mabecabu/farasis_p10a_pack/pcb/bms/bms.xlsx

Prj: | bms.xml |  |  |  |  | Board Qty: | 100
Co.: |  |  |  |  |  | Unit Cost: | $0.00
Prj date: | 5/12/2021 21:36:38 |  |  |  |  | Total Cost: | $0.00 |  |  |  | $0.00 | 0 |  |  |  | $0.00 | 0
$ date: | 2021-05-12 21:39:04
Global Part Info |  |  |  |  |  |  |  | Digi-Key |  |  |  |  | Mouser
Refs | Value | Footprint | Manf | Manf# | Qty | Unit$ | Ext$ | Avail | Purch | Unit$ | Ext$ | Cat# | Avail | Purch | Unit$ | Ext$ | Cat#
C1,C12 | 100p | C_0805_2012Metric | Kemet | C0805C101J1GACTU | 0 | $0.00 | $0.00 | 155151 |  | $0.00 | $0.00 | 399-1123-1-ND (https://octopart.com/click/track?ai=8078&sig=00b587c&sid=459&ppid=123666&vpid=1531783&ct=offers) | 46286 |  | $0.00 | $0.00 | 80C0805C101J1G (https://octopart.com/click/track?ai=8078&sig=068e5c8&sid=2401&ppid=123666&vpid=37714615&ct=offers)
C11,C21,C28,C29 | 1u | C_0805_2012Metric | Samsung Electro-Mechanics | CL21B105KBFNNNG | 0 | $0.00 | $0.00 | 1395000 |  | $0.00 | $0.00 | 1276-6470-1-ND (https://octopart.com/click/track?ai=8078&sig=0e430a3&sid=459&ppid=19995687&vpid=254014556&ct=offers) | NonStk |  | $0.00 | $0.00 | 187CL21B105KBFNNNG (https://octopart.com/click/track?c=1&ai=8078&sig=0276fd4&sid=2401&ppid=19995687&vpid=659501615&ct=offers)
C13 | 470n | C_0805_2012Metric | Samsung Electro-Mechanics | CL21B473KCCWPNC | 0 | $0.00 | $0.00 | 187459 |  | $0.00 | $0.00 | 1276-6815-1-ND (https://octopart.com/click/track?ai=8078&sig=045a58f&sid=459&ppid=30507372&vpid=254260088&ct=offers) | 79715 |  | $0.00 | $0.00 | 187CL21B473KCCWPNC (https://octopart.com/click/track?ai=8078&sig=072d3b9&sid=2401&ppid=30507372&vpid=659501796&ct=offers)
C15 | 4.7u | C_0805_2012Metric | Samsung Electro-Mechanics | CL21A475KOCLRNC | 0 | $0.00 | $0.00 | 180000 |  | $0.00 | $0.00 | 1276-2416-1-ND (https://octopart.com/click/track?ai=8078&sig=04f091f&sid=459&ppid=19832222&vpid=72525891&ct=offers) | 63245 |  | $0.00 | $0.00 | 187CL21A475KOCLRNC (https://octopart.com/click/track?ai=8078&sig=0216e42&sid=2401&ppid=19832222&vpid=658751409&ct=offers)
C2,C16-C20,C23,C27,C30-C33 | 100n | C_0805_2012Metric | Samsung Electro-Mechanics | CL21B104KCFSFNE | 0 | $0.00 | $0.00 | 466 |  | $0.00 | $0.00 | 1276-2923-1-ND (https://octopart.com/click/track?ai=8078&sig=090676c&sid=459&ppid=19832274&vpid=72526089&ct=offers) | 8757 |  | $0.00 | $0.00 | 187CL21B104KCFSFNE (https://octopart.com/click/track?ai=8078&sig=059a113&sid=2401&ppid=19832274&vpid=659501593&ct=offers)
C22 | 10n | C_0805_2012Metric | Samsung Electro-Mechanics | CL21B103KBANNNC | 0 | $0.00 | $0.00 | 821659 |  | $0.00 | $0.00 | 1276-1015-1-ND (https://octopart.com/click/track?ai=8078&sig=068d027&sid=459&ppid=9299349&vpid=72526018&ct=offers) | 15878 |  | $0.00 | $0.00 | 187CL21B103KBANNNC (https://octopart.com/click/track?ai=8078&sig=0e57c83&sid=2401&ppid=9299349&vpid=659501561&ct=offers)
C26 | 22n | C_0805_2012Metric | Samsung Electro-Mechanics | CL21B223KBANFNC | 0 | $0.00 | $0.00 | 74889 |  | $0.00 | $0.00 | 1276-2488-1-ND (https://octopart.com/click/track?ai=8078&sig=08f2074&sid=459&ppid=19832343&vpid=72526332&ct=offers) | 158177 |  | $0.00 | $0.00 | 187CL21B223KBANFNC (https://octopart.com/click/track?ai=8078&sig=0c7c7af&sid=2401&ppid=19832343&vpid=659501677&ct=offers)
C34,C36 | 8p | C_0805_2012Metric | Yaego | CC0805CRNPO9BN8R0 | 0 | $0.00 | $0.00 | 7888 |  | $0.00 | $0.00 | 311-4151-1-ND (https://octopart.com/click/track?c=1&ai=8078&sig=04d3e2d&sid=459&ppid=71334518&vpid=457175430&ct=offers)
C35 | 2.2u | C_0805_2012Metric | Samsung Electro-Mechanics | CL21B225KPFNNNE | 0 | $0.00 | $0.00 | 230183 |  | $0.00 | $0.00 | 1276-1188-1-ND (https://octopart.com/click/track?ai=8078&sig=0da4d98&sid=459&ppid=9291904&vpid=72526426&ct=offers) | 39439 |  | $0.00 | $0.00 | 187CL21B225KPFNNNE (https://octopart.com/click/track?ai=8078&sig=042a960&sid=2401&ppid=9291904&vpid=658751446&ct=offers)
C3-C10,C14,C24,C25 | 220n | C_0805_2012Metric | Kemet | C0805C224K1RECAUTO | 0 | $0.00 | $0.00 | 7989 |  | $0.00 | $0.00 | 399-17890-1-ND (https://octopart.com/click/track?ai=8078&sig=00debeb&sid=459&ppid=91527630&vpid=477966265&ct=offers) | 12561 |  | $0.00 | $0.00 | 80C0805C224K1RECAUT (https://octopart.com/click/track?ai=8078&sig=0cb96bb&sid=2401&ppid=91527630&vpid=481662233&ct=offers)
D1,D3,D5 | 100V | D_SOD-123 | Diodes Inc | BAT46W-7-F | 0 | $0.00 | $0.00
D2,D4 | 16V | D_SOD-123 | Diodes Inc | MMSZ5246B-7-F | 0 | $0.00 | $0.00
D9 | 48V | D_SMB | Littelfuse | SMBJ48A | 0 | $0.00 | $0.00 | 4662 |  | $0.00 | $0.00 | SMBJ48ALFCT-ND (https://octopart.com/click/track?ai=8078&sig=0f7ec1f&sid=459&ppid=350932&vpid=1629154&ct=offers) | 2092 |  | $0.00 | $0.00 | 576SMBJ48A (https://octopart.com/click/track?ai=8078&sig=00584be&sid=2401&ppid=350932&vpid=37738827&ct=offers)
D6-D8 | 5.5V | SOT-23 | TI | TPD2E2U06QDBZRQ1 | 0 | $0.00 | $0.00 | NonStk |  | $0.00 | $0.00 | 296-40695-1-ND (https://octopart.com/click/track?c=1&ai=8078&sig=0e8c40f&sid=459&ppid=52437806&vpid=192871289&ct=offers) | 3175 |  | $0.00 | $0.00 | 595TPD2E2U06QDBZRQ1 (https://octopart.com/click/track?ai=8078&sig=066c468&sid=2401&ppid=52437806&vpid=201388535&ct=offers)
H5-H8 | MountingHole | MountingHole_3.2mm_M3 |  |  | 0 | $0.00 | $0.00
J1 | Taps 0-5 | PinHeader_1x05_P2.54mm_Vertical |  |  | 0 | $0.00 | $0.00
J10 | Signals | Hirose_DF62WZ-9P-2.2DSA | Hirose Electric Co Ltd | DF62WZ-9P-2.2DSA(50) | 0 | $0.00 | $0.00
J2 | Taps 6-8 | PinHeader_1x04_P2.54mm_Vertical |  |  | 0 | $0.00 | $0.00
J3 | Taps 9-10 | PinHeader_1x02_P2.54mm_Vertical |  |  | 0 | $0.00 | $0.00
J4 | Batt- Out | 74651195R | Wurth Elektronik | 74651195R | 0 | $0.00 | $0.00
J5 | Batt+ In | 74651195R | Wurth Elektronik | 74651195R | 0 | $0.00 | $0.00
J6 | Batt- In | 74651195R | Wurth Elektronik | 74651195R | 0 | $0.00 | $0.00
J7 | Batt+ Out | 74651195R | Wurth Elektronik | 74651195R | 0 | $0.00 | $0.00
J8 | SWD | PinHeader_1x04_P2.54mm_Horizontal | Adam Tech | PH1RB-04-UA | 0 | $0.00 | $0.00
J9 | Thermistors | JST_NSH_SM04B-NSHSS-TB_1x04-1MP_P1.00mm_Vertical | JST | SM04B-NSHSS-TB (LF)(SN) | 0 | $0.00 | $0.00 | 3449 |  | $0.00 | $0.00 | 455-2774-1-ND (https://octopart.com/click/track?ai=8078&sig=0c04254&sid=459&ppid=22884277&vpid=50103598&ct=offers)
JP7,JP9 | Jumper_NO_Small | SolderJumper-2_P1.3mm_Open_RoundedPad1.0x1.5mm |  |  | 0 | $0.00 | $0.00
Q1 | FCX495TA | SOT-89-3 | Diodes Inc | FCX495TA | 0 | $0.00 | $0.00
Q2,Q3 | CSD19506KTT | TO-263-2 | TI | CSD19506KTT | 0 | $0.00 | $0.00 | 129 |  | $0.00 | $0.00 | 296-49604-1-ND (https://octopart.com/click/track?ai=8078&sig=0270565&sid=459&ppid=71513265&vpid=486679130&ct=offers) | 438 |  | $0.00 | $0.00 | 595CSD19506KTT (https://octopart.com/click/track?ai=8078&sig=0b78196&sid=2401&ppid=71513265&vpid=261392702&ct=offers)
Q4,Q5 | ZXMP10A13FTA | SOT-23 | Diodes Inc | ZXMP10A13FTA | 0 | $0.00 | $0.00
R1,R3,R36 | 100 | R_0805_2012Metric | Bourns Inc | CR0805-FX-1000ELF | 0 | $0.00 | $0.00
R2 | 1m | R_2512_6332Metric | Riedon | CSR2512C0R001F | 0 | $0.00 | $0.00 | 30118 |  | $0.00 | $0.00 | 696-1185-1-ND (https://octopart.com/click/track?c=1&ai=8078&sig=0b731cc&sid=459&ppid=29379677&vpid=77874757&ct=offers)
R20,R21 | 150 | R_0805_2012Metric | Stackpole Electronics | RMCF0805FT150R | 0 | $0.00 | $0.00
R25,R31,R33 | 5.1k | R_0805_2012Metric | Stackpole Electronics | RMCF0805FT5K10 | 0 | $0.00 | $0.00
R28 | 1k | R_0805_2012Metric | Bourns Inc | CR0805-FX-1001ELF | 0 | $0.00 | $0.00
R29,R35 | 3.9k | R_0805_2012Metric | Stackpole Electronics | RMCF0805FT3K90 | 0 | $0.00 | $0.00
R30,R34 | 1M | R_0805_2012Metric | Stackpole Electronics | RMCF0805FT1M00 | 0 | $0.00 | $0.00
R32 | 10M | R_0805_2012Metric | Stackpole Electronics | RMCF0805FT10M0 | 0 | $0.00 | $0.00
R42 | Rext | R_0805_2012Metric |  |  | 0 | $0.00 | $0.00
R15-R19,R22-R24,R26,R27,R39 | 10k | R_0805_2012Metric | Stackpole Electronics | RMCF0805FT10K0 | 0 | $0.00 | $0.00
R4-R14,R37,R38,R40,R41 | 20 | R_0805_2012Metric | Stackpole Electronics | RMCF0805FT20R0 | 0 | $0.00 | $0.00
SW1 | Boot | SW_SPST_PTS645 | C&K | PTS645SK50SMTR92 LFS | 0 | $0.00 | $0.00 | 86667 |  | $0.00 | $0.00 | CKN9087CT-ND (https://octopart.com/click/track?ai=8078&sig=09e5738&sid=459&ppid=55397152&vpid=76879281&ct=offers) | 16210 |  | $0.00 | $0.00 | 611PTS645SK50SMTR92 (https://octopart.com/click/track?ai=8078&sig=0341a0e&sid=2401&ppid=55397152&vpid=480548417&ct=offers)
SW2 | Wake | SW_SPST_PTS645 | C&K | PTS645SK50SMTR92 LFS | 0 | $0.00 | $0.00 | 86667 |  | $0.00 | $0.00 | CKN9087CT-ND (https://octopart.com/click/track?ai=8078&sig=09e5738&sid=459&ppid=55397152&vpid=76879281&ct=offers) | 16210 |  | $0.00 | $0.00 | 611PTS645SK50SMTR92 (https://octopart.com/click/track?ai=8078&sig=0341a0e&sid=2401&ppid=55397152&vpid=480548417&ct=offers)
SW3 | RST | SW_SPST_PTS645 | C&K | PTS645SK50SMTR92 LFS | 0 | $0.00 | $0.00 | 86667 |  | $0.00 | $0.00 | CKN9087CT-ND (https://octopart.com/click/track?ai=8078&sig=09e5738&sid=459&ppid=55397152&vpid=76879281&ct=offers) | 16210 |  | $0.00 | $0.00 | 611PTS645SK50SMTR92 (https://octopart.com/click/track?ai=8078&sig=0341a0e&sid=2401&ppid=55397152&vpid=480548417&ct=offers)
U1 | BQ76942PFBR | LQFP-48_7x7mm_P0.5mm | TI | BQ7694201PFBR (http://www.ti.com/lit/ds/symlink/bq76942.pdf) | 0 | $0.00 | $0.00 | 1000 |  | $0.00 | $0.00 | 296-BQ7694201PFBRCT-ND (https://octopart.com/click/track?ai=8078&sig=09dce1d&sid=459&ppid=117420950&vpid=714643240&ct=offers) | 1000 |  | $0.00 | $0.00 | 595BQ7694201PFBR (https://octopart.com/click/track?ai=8078&sig=07372d3&sid=2401&ppid=117420950&vpid=712074037&ct=offers)
U2 | STM32L422KBTx | LQFP-32_7x7mm_P0.8mm | ST | STM32L422KBT6 (http://www.st.com/st-web-ui/static/active/en/resource/technical/document/datasheet/DM00257195.pdf) | 0 | $0.00 | $0.00 | NonStk |  | $0.00 | $0.00 | 497-18235-ND (https://octopart.com/click/track?c=1&ai=8078&sig=04dcc13&sid=459&ppid=94438346&vpid=504000639&ct=offers) | NonStk |  | $0.00 | $0.00 | 511STM32L422KBT6 (https://octopart.com/click/track?c=1&ai=8078&sig=0428c7c&sid=2401&ppid=94438346&vpid=503983560&ct=offers)
X1 | ASCO | Oscillator_SMD_Abracon_ASCO-4Pin_1.6x1.2mm | Abracon LLC | ASCO-8.000MHZ-EK-T3 (https://abracon.com/Oscillators/ASCO.pdf) | 0 | $0.00 | $0.00
Y1 | 32.768kHz | Crystal_SMD_MicroCrystal_CC8V-T1A-2Pin_2.0x1.2mm_HandSoldering | Micro Crystal AG | CM8V-T1A-32.768KHZ-9PF-20PPM-TB-QA | 0 | $0.00 | $0.00
 |  |  |  |  |  | Total Purchase: | $0.00 |  | 0 |  | $0.00 |  |  | 0 |  | $0.00
KiCost® v.1.1.4 |  |  |  |  |  | Purchase description: |  |  | 0 |  |  |  |  | 0
 |  |  |  |  |  |  |  |  | 0 |  |  |  |  | 0
 |  |  |  |  |  |  |  |  | 0 |  |  |  |  | 0
 |  |  |  |  |  |  |  |  | 0 |  |  |  |  | 0
 |  |  |  |  |  |  |  |  | 0 |  |  |  |  | 0
 |  |  |  |  |  |  |  |  | 0 |  |  |  |  | 0
 |  |  |  |  |  |  |  |  | 0 |  |  |  |  | 0
 |  |  |  |  |  |  |  |  | 0 |  |  |  |  | 0
 |  |  |  |  |  |  |  |  | 0 |  |  |  |  | 0
 |  |  |  |  |  |  |  |  | 0 |  |  |  |  | 0
 |  |  |  |  |  |  |  |  | 0 |  |  |  |  | 0
 |  |  |  |  |  |  |  |  | 0 |  |  |  |  | 0
 |  |  |  |  |  |  |  |  | 0 |  |  |  |  | 0
 |  |  |  |  |  |  |  |  | 0 |  |  |  |  | 0
 |  |  |  |  |  |  |  |  | 0 |  |  |  |  | 0
 |  |  |  |  |  |  |  |  | 0 |  |  |  |  | 0
 |  |  |  |  |  |  |  |  | 0 |  |  |  |  | 0
 |  |  |  |  |  |  |  |  | 0 |  |  |  |  | 0
 |  |  |  |  |  |  |  |  | 0 |  |  |  |  | 0
 |  |  |  |  |  |  |  |  | 0 |  |  |  |  | 0
 |  |  |  |  |  |  |  |  | 0 |  |  |  |  | 0
 |  |  |  |  |  |  |  |  | 0 |  |  |  |  | 0
 |  |  |  |  |  |  |  |  | 0 |  |  |  |  | 0
 |  |  |  |  |  |  |  |  | 0 |  |  |  |  | 0
 |  |  |  |  |  |  |  |  | 0 |  |  |  |  | 0
 |  |  |  |  |  |  |  |  | 0 |  |  |  |  | 0
 |  |  |  |  |  |  |  |  | 0 |  |  |  |  | 0
 |  |  |  |  |  |  |  |  | 0 |  |  |  |  | 0
 |  |  |  |  |  |  |  |  | 0 |  |  |  |  | 0
 |  |  |  |  |  |  |  |  | 0 |  |  |  |  | 0
 |  |  |  |  |  |  |  |  | 0 |  |  |  |  | 0
 |  |  |  |  |  |  |  |  | 0 |  |  |  |  | 0
 |  |  |  |  |  |  |  |  | 0 |  |  |  |  | 0
 |  |  |  |  |  |  |  |  | 0 |  |  |  |  | 0
 |  |  |  |  |  |  |  |  | 0 |  |  |  |  | 0
 |  |  |  |  |  |  |  |  | 0 |  |  |  |  | 0
 |  |  |  |  |  |  |  |  | 0 |  |  |  |  | 0
 |  |  |  |  |  |  |  |  | 0 |  |  |  |  | 0
 |  |  |  |  |  |  |  |  | 0 |  |  |  |  | 0
 |  |  |  |  |  |  |  |  | 0 |  |  |  |  | 0
 |  |  |  |  |  |  |  |  | 0 |  |  |  |  | 0
 |  |  |  |  |  |  |  |  | 0 |  |  |  |  | 0
 |  |  |  |  |  |  |  |  | 0 |  |  |  |  | 0
 |  |  |  |  |  |  |  |  | 0 |  |  |  |  | 0
 |  |  |  |  |  |  |  |  | 0 |  |  |  |  | 0
 |  |  |  |  |  |  |  |  | 0 |  |  |  |  | 0
 |  |  |  |  |  |  |  |  | 0 |  |  |  |  | 0
