mabecabu/farasis_p10a_pack/pcb/cell_interconnect/cell_interconnect.kicad_pcb

## KiCad design pcb/cell_interconnect/cell_interconnect.kicad_pcb (2021-05-13)

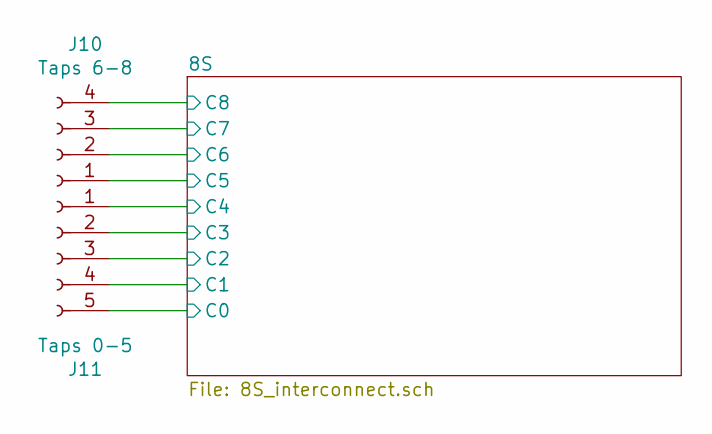
[picture p1: schematic cell_interconnect.sch]

Parts:
J10: Taps 6-8; PinSocket_1x04_P2.54mm_Vertical
J11: Taps 0-5; PinSocket_1x05_P2.54mm_Vertical

Connections:
/8S/C0: J11.5; also elsewhere on the board
/8S/C1: J11.4; also elsewhere on the board
/8S/C2: J11.3; also elsewhere on the board
/8S/C3: J11.2; also elsewhere on the board
/8S/C4: J11.1; also elsewhere on the board
/8S/C5: J10.1; also elsewhere on the board
/8S/C6: J10.2; also elsewhere on the board
/8S/C7: J10.3; also elsewhere on the board
/8S/C8: J10.4; also elsewhere on the board

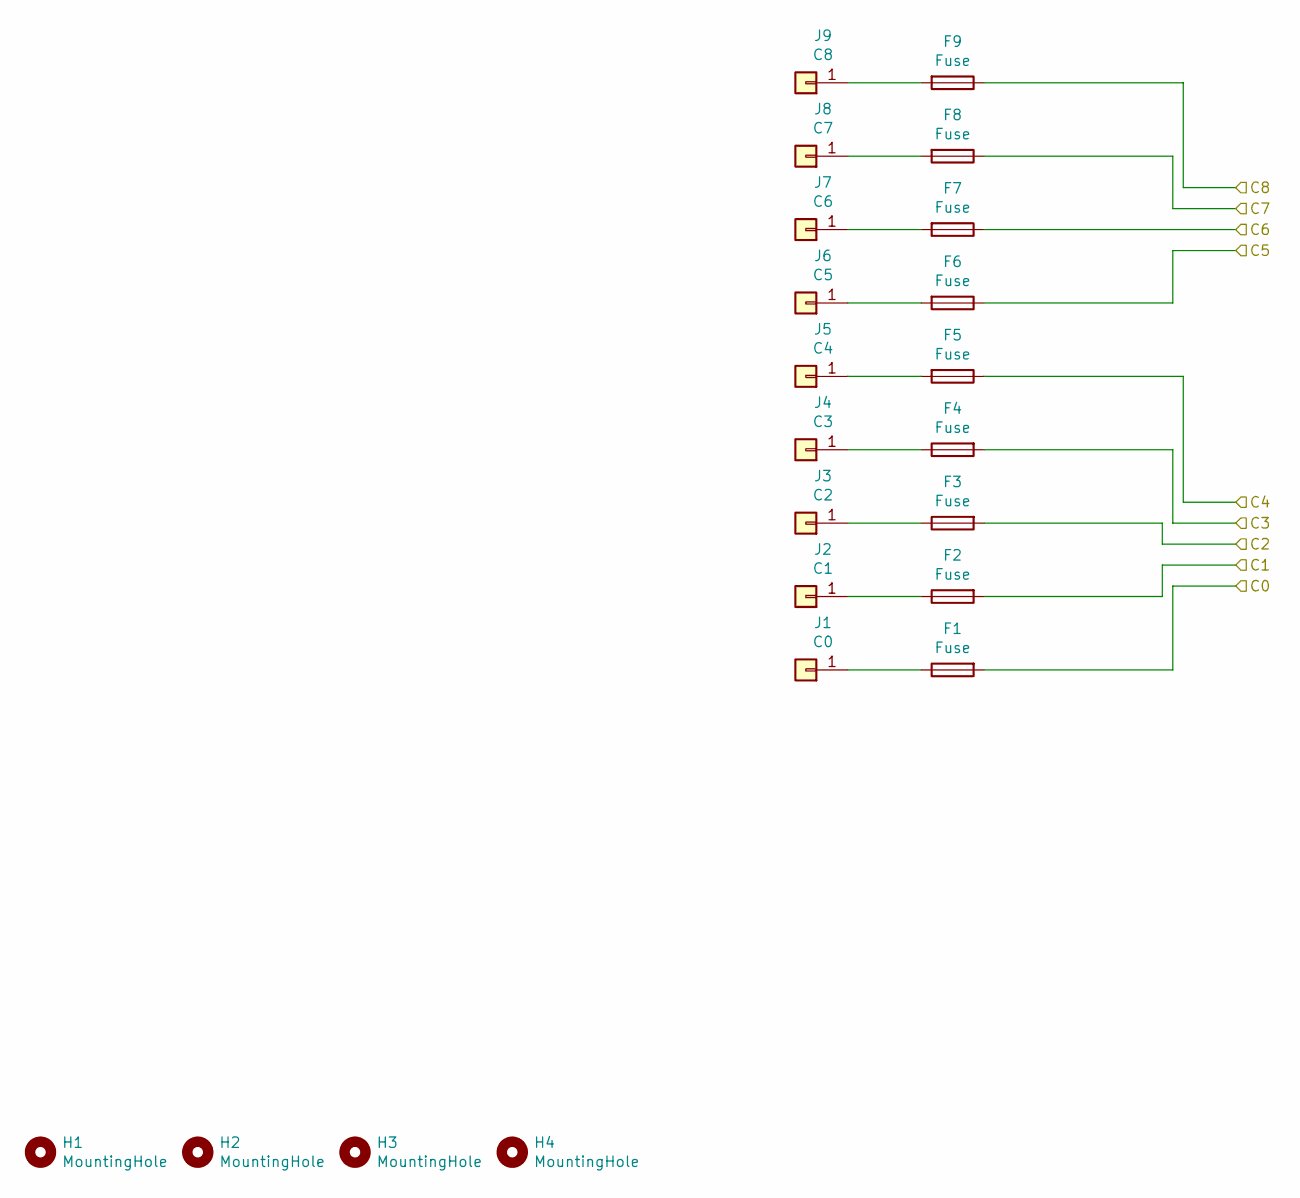
[picture p2: schematic 8S_interconnect.sch]

Parts:
F1, F2, F3, F4, F5, F6, F7, F9: Fuse; R_0603_1608Metric
F8: Fuse; R_0603_1608Metric; MPN C2Q 300
H1, H2, H3, H4: MountingHole; MountingHole_3.2mm_M3
J1: C0; farasis_p10a_end_tab_offset_right
J2: C1; farasis_p10a_tab
J3: C2; farasis_p10a_tab
J4: C3; farasis_p10a_tab
J5: C4; farasis_p10a_tab
J6: C5; farasis_p10a_tab
J7: C6; farasis_p10a_tab
J8: C7; farasis_p10a_tab
J9: C8; farasis_p10a_end_tab_offset_left

Connections:
/8S/C0: F1.2; also elsewhere on the board
/8S/C1: F2.2; also elsewhere on the board
/8S/C2: F3.2; also elsewhere on the board
/8S/C3: F4.2; also elsewhere on the board
/8S/C4: F5.1; also elsewhere on the board
/8S/C5: F6.1; also elsewhere on the board
/8S/C6: F7.1; also elsewhere on the board
/8S/C7: F8.1; also elsewhere on the board
/8S/C8: F9.1; also elsewhere on the board
unnamed: F1.1, J1.1
unnamed: F2.1, J2.1
unnamed: F3.1, J3.1
unnamed: F4.1, J4.1
unnamed: F5.2, J5.1
unnamed: F6.2, J6.1
unnamed: F7.2, J7.1
unnamed: F8.2, J8.1
unnamed: F9.2, J9.1

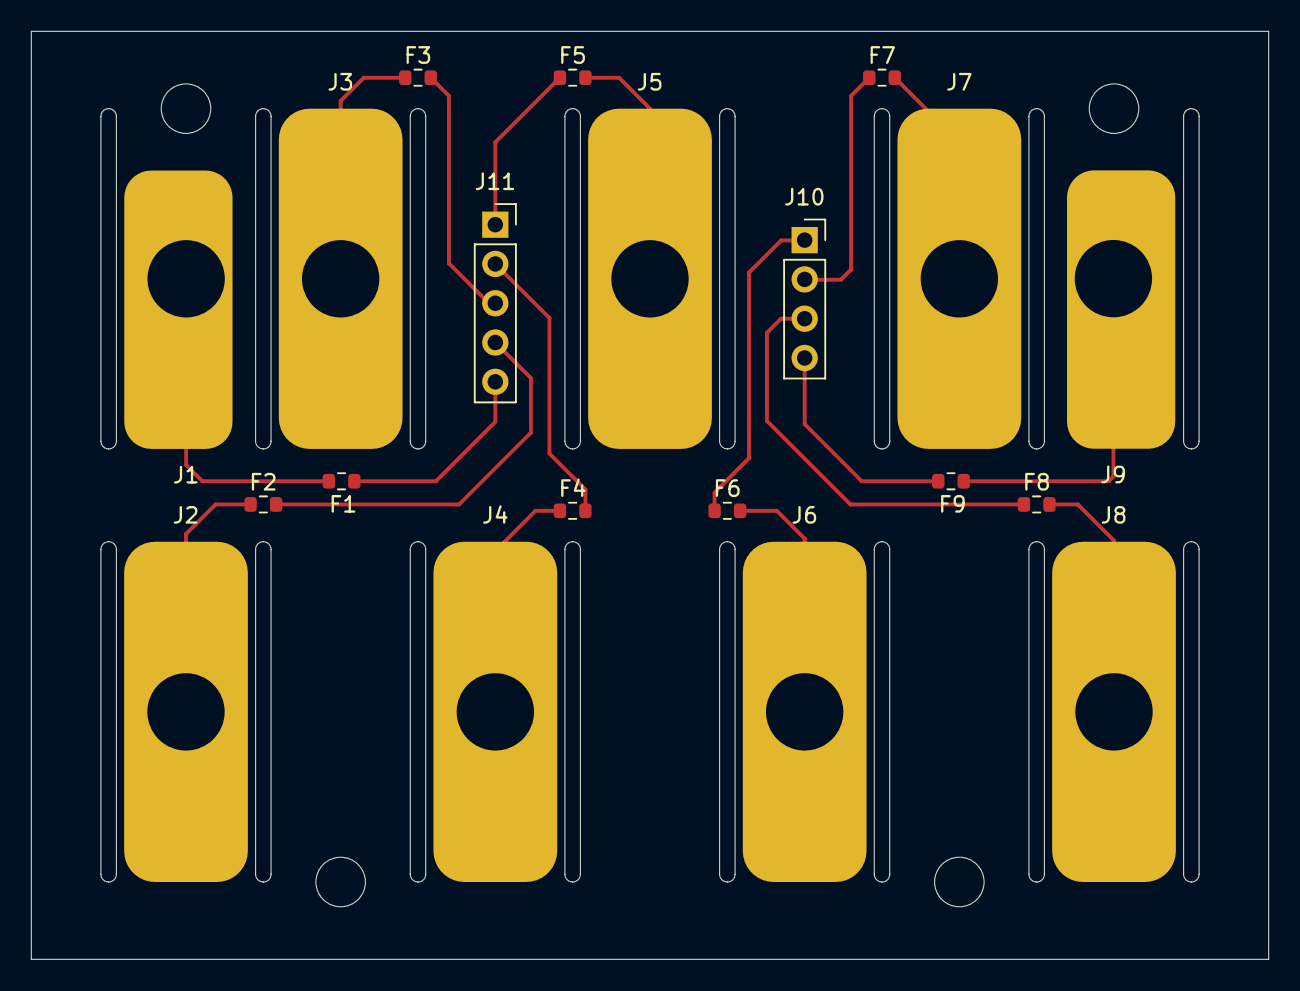
[picture p3: board cell_interconnect.kicad_pcb from above]

Board: 2 copper layers, 80.0 x 60.0 mm, 24 parts (0 on the bottom side), 18 nets.
