mabecabu/farasis_p10a_pack/pcb/bms/bms.kicad_pcb

## KiCad design pcb/bms/bms.kicad_pcb (2021-05-13)

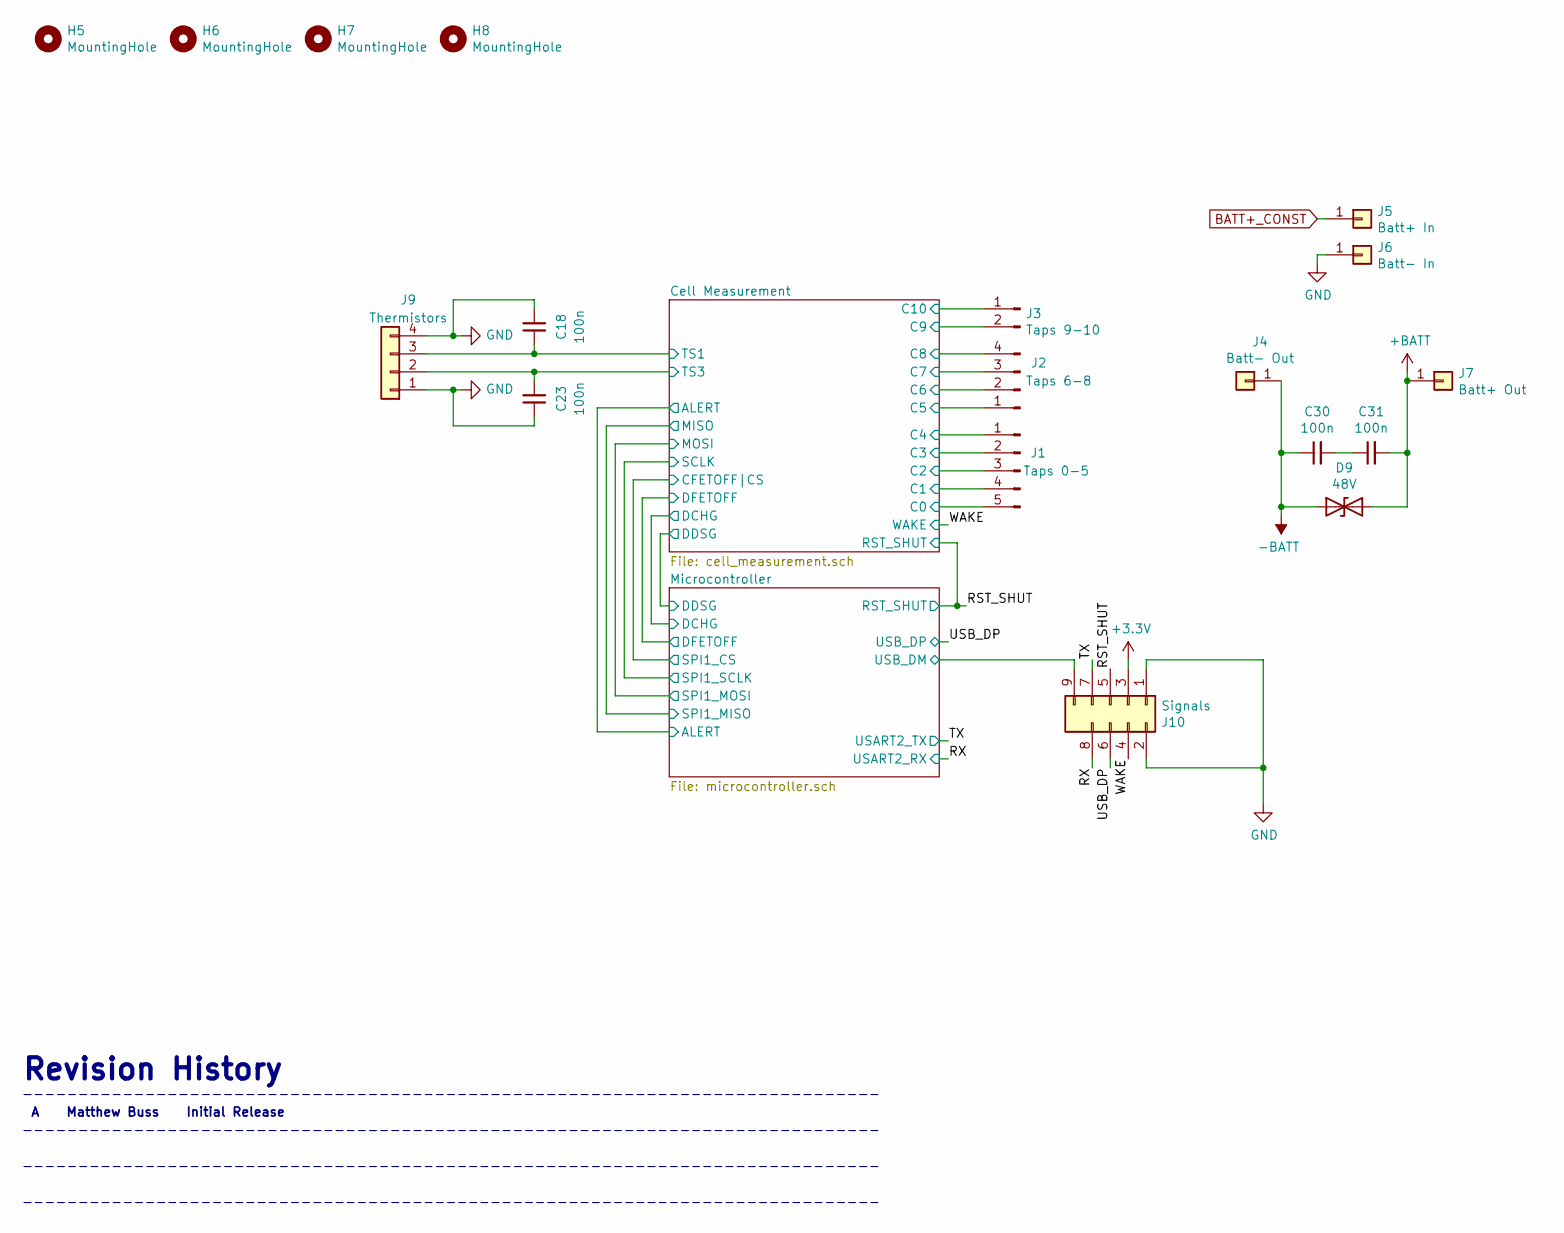
[picture p4: schematic bms.sch]

Parts:
C18, C23, C30, C31: 100n; C_0805_2012Metric; MPN CL21B104KCFSFNE
D9: 48V; D_SMB; MPN SMBJ48A
H5, H6, H7, H8: MountingHole; MountingHole_3.2mm_M3
J1: Taps 0-5; PinHeader_1x05_P2.54mm_Vertical
J2: Taps 6-8; PinHeader_1x04_P2.54mm_Vertical
J3: Taps 9-10; PinHeader_1x02_P2.54mm_Vertical
J4: Batt- Out; 74651195R; MPN 74651195R
J5: Batt+ In; 74651195R; MPN 74651195R
J6: Batt- In; 74651195R; MPN 74651195R
J7: Batt+ Out; 74651195R; MPN 74651195R
J9: Thermistors; JST_NSH_SM04B-NSHSS-TB_1x04-1MP_P1.00mm_Vertical; MPN SM04B-NSHSS-TB (LF)(SN)
J10: Signals; Hirose_DF62WZ-9P-2.2DSA; MPN DF62WZ-9P-2.2DSA(50)

Connections:
+3V3: J10.3; also elsewhere on the board
+BATT: C31.2, D9.2 (A2), J7.1; also elsewhere on the board
-BATT: C30.1, D9.1 (A1), J4.1; also elsewhere on the board
/Cell Measurement/C0: J1.5; also elsewhere on the board
/Cell Measurement/C1: J1.4; also elsewhere on the board
/Cell Measurement/C2: J1.3; also elsewhere on the board
/Cell Measurement/C3: J1.2; also elsewhere on the board
/Cell Measurement/C4: J1.1; also elsewhere on the board
/Cell Measurement/C5: J2.1; also elsewhere on the board
/Cell Measurement/C6: J2.2; also elsewhere on the board
/Cell Measurement/C7: J2.3; also elsewhere on the board
/Cell Measurement/C8: J2.4; also elsewhere on the board
/Cell Measurement/C9: J3.2; also elsewhere on the board
/Cell Measurement/C10: J3.1; also elsewhere on the board
/Cell Measurement/TS1: C18.1, J9.3; also elsewhere on the board
/Cell Measurement/TS3: C23.2, J9.2; also elsewhere on the board
/Microcontroller/USB_DM: J10.9; also elsewhere on the board
/RST_SHUT: J10.5; also elsewhere on the board
/RX: J10.8; also elsewhere on the board
/TX: J10.7; also elsewhere on the board
/USB_DP: J10.6; also elsewhere on the board
/WAKE: J10.4; also elsewhere on the board
BATT+_CONST: J5.1; also elsewhere on the board
GND: C18.2, C23.1, J6.1, J9.1, J9.4, J10.1, J10.2; also elsewhere on the board
unnamed: C30.2, C31.1

Notes on the sheet:
Revision History
-----------------------------------------------------------------------------
A Matthew Buss Initial Release

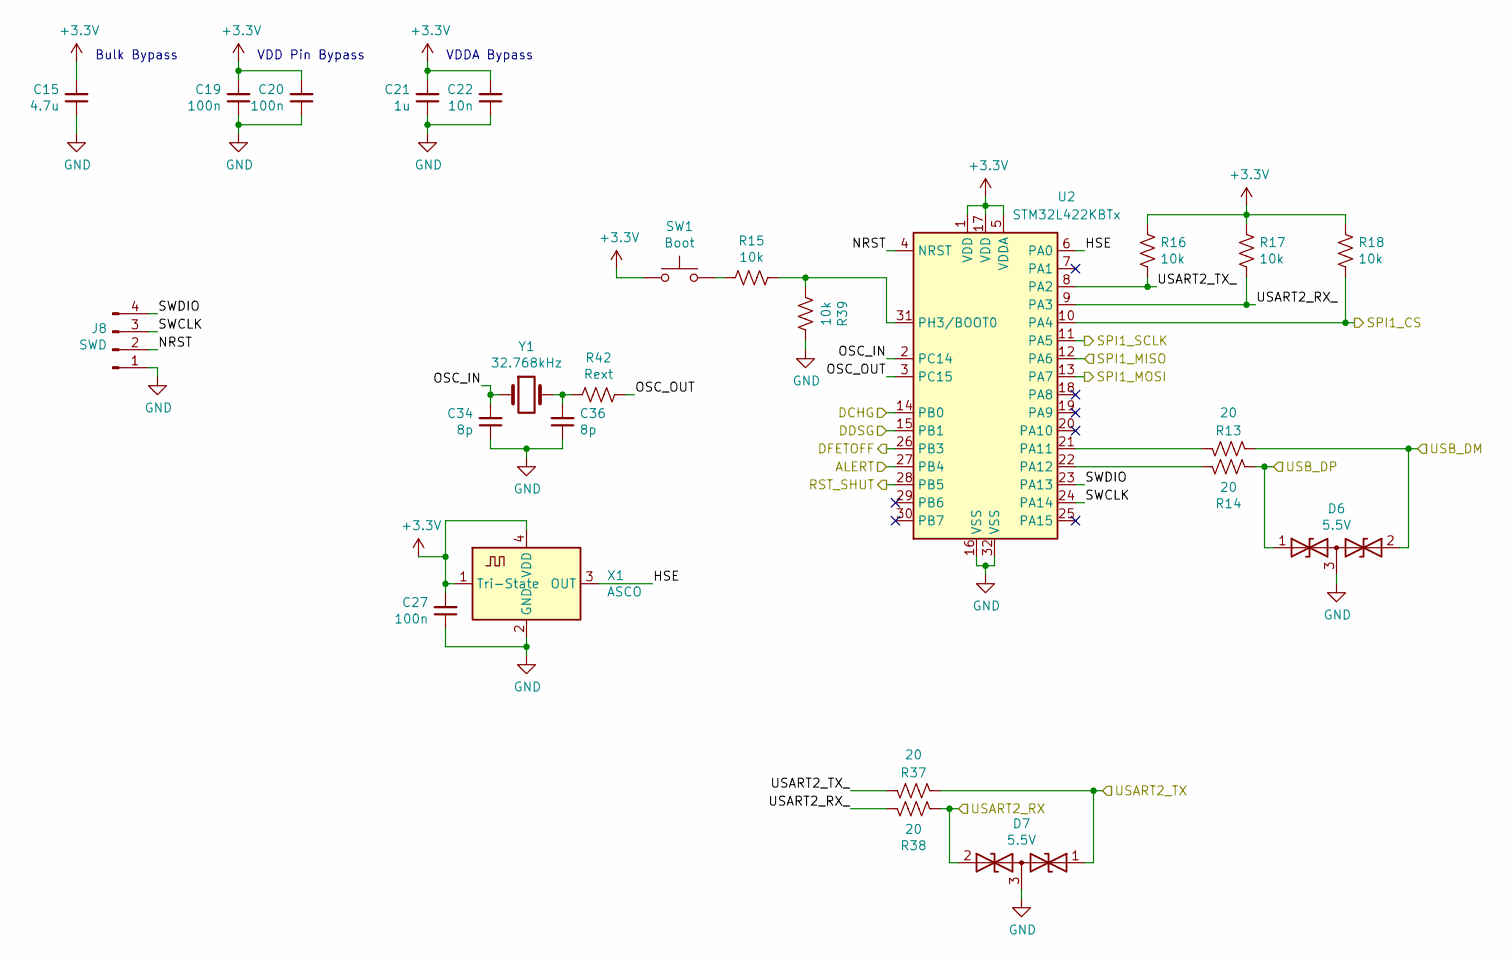
[picture p5: schematic microcontroller.sch]

Parts:
C15: 4.7u; C_0805_2012Metric; MPN CL21A475KOCLRNC
C19, C20, C27: 100n; C_0805_2012Metric; MPN CL21B104KCFSFNE
C21: 1u; C_0805_2012Metric; MPN CL21B105KBFNNNG
C22: 10n; C_0805_2012Metric; MPN CL21B103KBANNNC
C34, C36: 8p; C_0805_2012Metric; MPN CC0805CRNPO9BN8R0
D6, D7: 5.5V; SOT-23; MPN TPD2E2U06QDBZRQ1
J8: SWD; PinHeader_1x04_P2.54mm_Horizontal; MPN PH1RB-04-UA
R13, R14, R37, R38: 20; R_0805_2012Metric; MPN RMCF0805FT20R0
R15, R16, R17, R18, R39: 10k; R_0805_2012Metric; MPN RMCF0805FT10K0
R42: Rext; R_0805_2012Metric
SW1: Boot; SW_SPST_PTS645; MPN PTS645SK50SMTR92 LFS
U2: STM32L422KBTx; LQFP-32_7x7mm_P0.8mm; MPN STM32L422KBT6
X1: ASCO; Oscillator_SMD_Abracon_ASCO-4Pin_1.6x1.2mm; MPN ASCO-8.000MHZ-EK-T3
Y1: 32.768kHz; Crystal_SMD_MicroCrystal_CC8V-T1A-2Pin_2.0x1.2mm_HandSolder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; MPN CM8V-T1A-32.768KHZ-9PF-20PPM-TB-QA

Connections:
+3V3: C15.2, C19.2, C20.2, C21.2, C22.2, C27.2, R16.1, R17.1, R18.1, SW1.1, U2.1 (VDD), U2.5 (VDDA), U2.17 (VDD), X1.1 (Tri-State), X1.4 (VDD); also elsewhere on the board
/Cell Measurement/ALERT: U2.27 (PB4); also elsewhere on the board
/Cell Measurement/CFETOFF|CS: R18.2, U2.10 (PA4); also elsewhere on the board
/Cell Measurement/DCHG: U2.14 (PB0); also elsewhere on the board
/Cell Measurement/DDSG: U2.15 (PB1); also elsewhere on the board
/Cell Measurement/DFETOFF: U2.26 (PB3); also elsewhere on the board
/Cell Measurement/MISO: U2.12 (PA6); also elsewhere on the board
/Cell Measurement/MOSI: U2.13 (PA7); also elsewhere on the board
/Cell Measurement/SCLK: U2.11 (PA5); also elsewhere on the board
/Microcontroller/HSE: U2.6 (PA0), X1.3 (OUT)
/Microcontroller/NRST: J8.2, U2.4 (NRST)
/Microcontroller/OSC_IN: C34.2, U2.2 (PC14), Y1.1
/Microcontroller/OSC_OUT: R42.1, U2.3 (PC15)
/Microcontroller/SWCLK: J8.3, U2.24 (PA14)
/Microcontroller/SWDIO: J8.4, U2.23 (PA13)
/Microcontroller/USART2_RX_: R17.2, R38.2, U2.9 (PA3)
/Microcontroller/USART2_TX_: R16.2, R37.2, U2.8 (PA2)
/Microcontroller/USB_DM: D6.2 (A2), R13.1; also elsewhere on the board
/RST_SHUT: U2.28 (PB5); also elsewhere on the board
/RX: D7.2 (A2), R38.1; also elsewhere on the board
/TX: D7.1 (A1), R37.1; also elsewhere on the board
/USB_DP: D6.1 (A1), R14.1; also elsewhere on the board
GND: C15.1, C19.1, C20.1, C21.1, C22.1, C27.1, C34.1, C36.1, D6.3 (common), D7.3 (common), J8.1, R39.1, U2.16 (VSS), U2.32 (VSS), X1.2 (GND); also elsewhere on the board
unnamed: C36.2, R42.2, Y1.2
unnamed: R13.2, U2.21 (PA11)
unnamed: R14.2, U2.22 (PA12)
unnamed: R15.1, R39.2, U2.31 (PH3/BOOT0)
unnamed: R15.2, SW1.2

Notes on the sheet:
Bulk Bypass
VDD Pin Bypass
VDDA Bypass

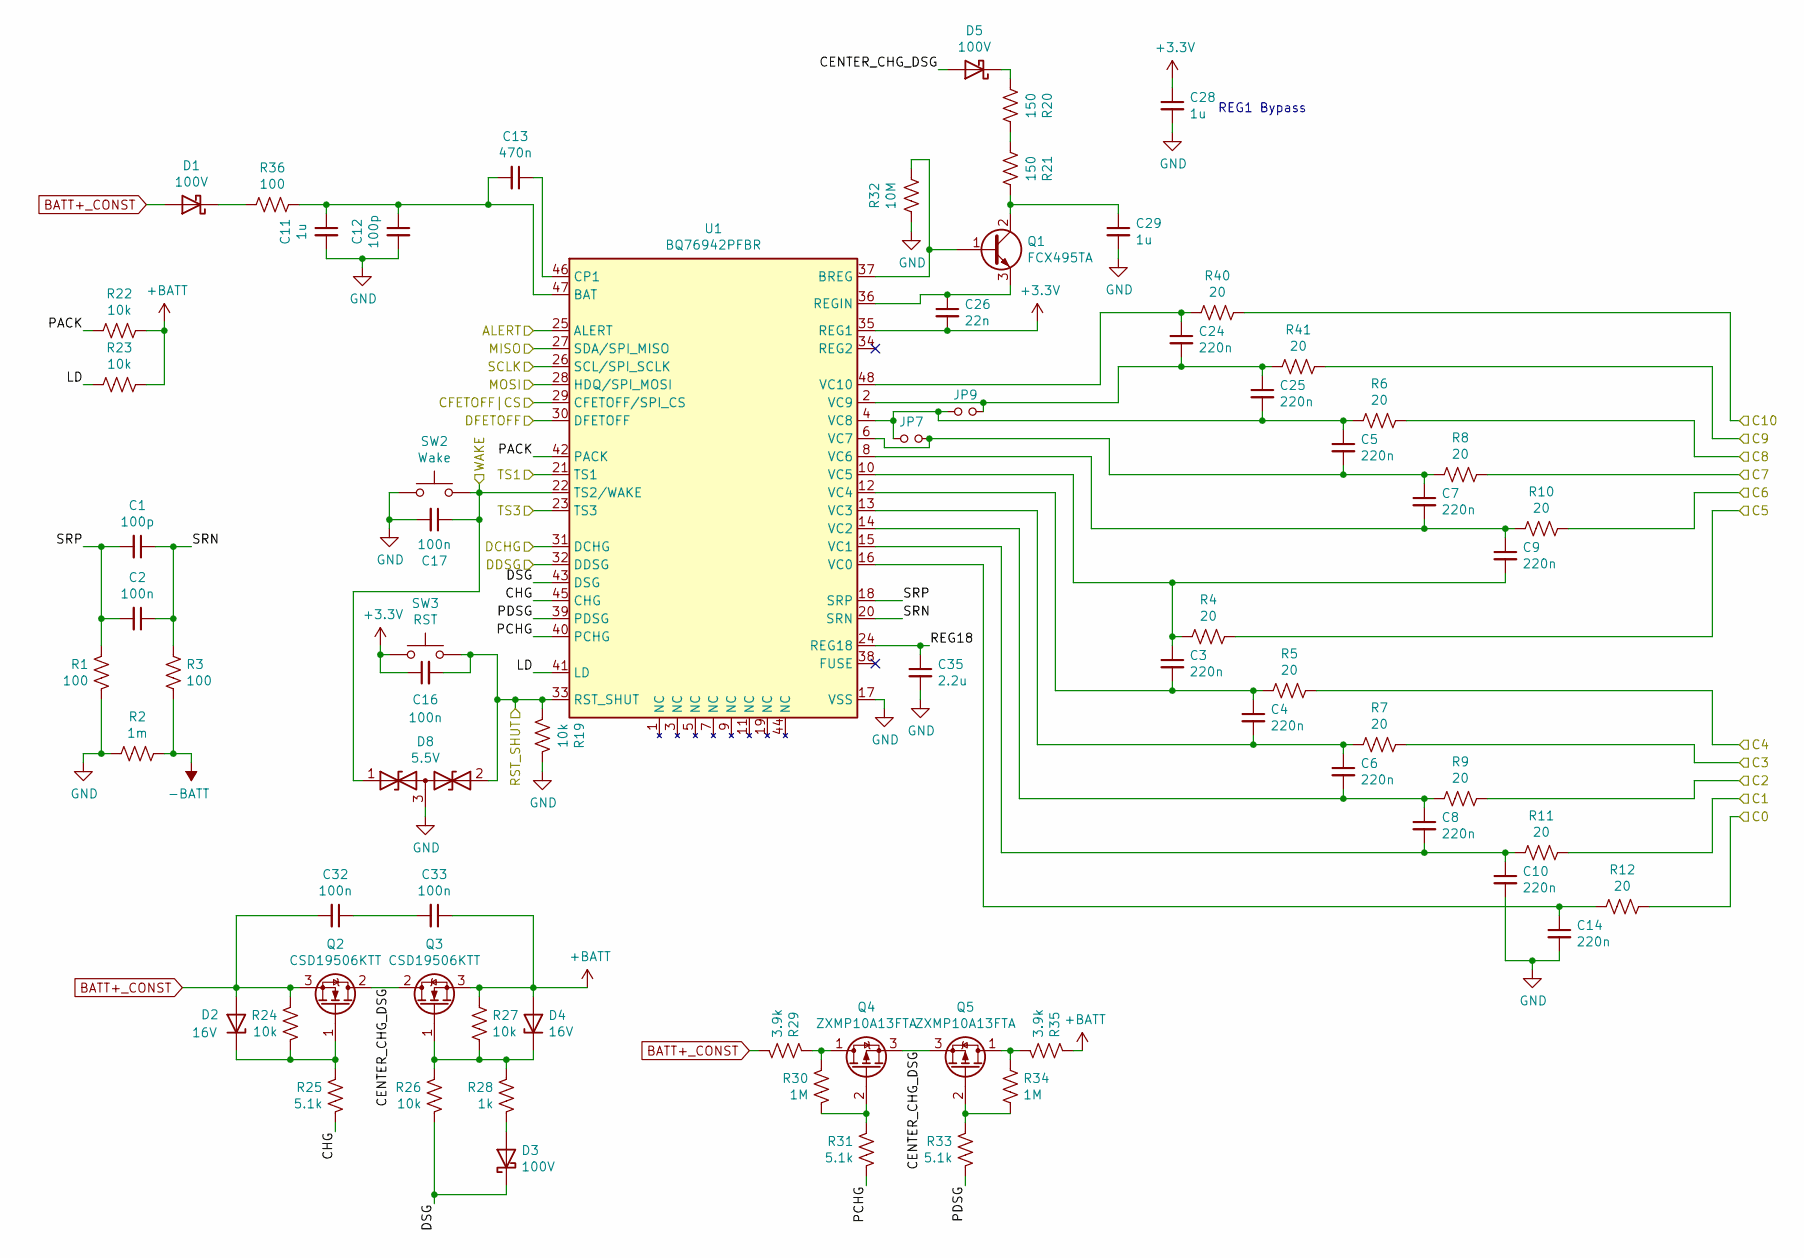
[picture p6: schematic cell_measurement.sch]

Parts:
C1, C12: 100p; C_0805_2012Metric; MPN C0805C101J1GACTU
C2, C16, C17, C32, C33: 100n; C_0805_2012Metric; MPN CL21B104KCFSFNE
C3, C4, C5, C6, C7, C8, C9, C10, C14, C24, C25: 220n; C_0805_2012Metric; MPN C0805C224K1RECAUTO
C11, C28, C29: 1u; C_0805_2012Metric; MPN CL21B105KBFNNNG
C13: 470n; C_0805_2012Metric; MPN CL21B473KCCWPNC
C26: 22n; C_0805_2012Metric; MPN CL21B223KBANFNC
C35: 2.2u; C_0805_2012Metric; MPN CL21B225KPFNNNE
D1, D3, D5: 100V; D_SOD-123; MPN BAT46W-7-F
D2, D4: 16V; D_SOD-123; MPN MMSZ5246B-7-F
D8: 5.5V; SOT-23; MPN TPD2E2U06QDBZRQ1
JP7, JP9: Jumper_NO_Small; SolderJumper-2_P1.3mm_Open_RoundedPad1.0x1.5mm
Q1: FCX495TA; SOT-89-3; MPN FCX495TA
Q2, Q3: CSD19506KTT; TO-263-2; MPN CSD19506KTT
Q4, Q5: ZXMP10A13FTA; SOT-23; MPN ZXMP10A13FTA
R1, R3, R36: 100; R_0805_2012Metric; MPN CR0805-FX-1000ELF
R2: 1m; R_2512_6332Metric; MPN CSR2512C0R001F
R4, R5, R6, R7, R8, R9, R10, R11, R12, R40, R41: 20; R_0805_2012Metric; MPN RMCF0805FT20R0
R19, R22, R23, R24, R26, R27: 10k; R_0805_2012Metric; MPN RMCF0805FT10K0
R20, R21: 150; R_0805_2012Metric; MPN RMCF0805FT150R
R25, R31, R33: 5.1k; R_0805_2012Metric; MPN RMCF0805FT5K10
R28: 1k; R_0805_2012Metric; MPN CR0805-FX-1001ELF
R29, R35: 3.9k; R_0805_2012Metric; MPN RMCF0805FT3K90
R30, R34: 1M; R_0805_2012Metric; MPN RMCF0805FT1M00
R32: 10M; R_0805_2012Metric; MPN RMCF0805FT10M0
SW2: Wake; SW_SPST_PTS645; MPN PTS645SK50SMTR92 LFS
SW3: RST; SW_SPST_PTS645; MPN PTS645SK50SMTR92 LFS
U1: BQ76942PFBR; LQFP-48_7x7mm_P0.5mm; MPN BQ7694201PFBR

Connections:
+3V3: C16.1, C26.2, C28.1, SW3.1, U1.35 (REG1); also elsewhere on the board
+BATT: C33.1, D4.2 (A), Q3.3 (S), R22.1, R23.1, R27.2, R35.2; also elsewhere on the board
-BATT: R2.1, R3.2; also elsewhere on the board
/Cell Measurement/ALERT: U1.25 (ALERT); also elsewhere on the board
/Cell Measurement/C0: R12.1; also elsewhere on the board
/Cell Measurement/C1: R11.1; also elsewhere on the board
/Cell Measurement/C2: R9.1; also elsewhere on the board
/Cell Measurement/C3: R7.1; also elsewhere on the board
/Cell Measurement/C4: R5.1; also elsewhere on the board
/Cell Measurement/C5: R4.1; also elsewhere on the board
/Cell Measurement/C6: R10.1; also elsewhere on the board
/Cell Measurement/C7: R8.1; also elsewhere on the board
/Cell Measurement/C8: R6.1; also elsewhere on the board
/Cell Measurement/C9: R41.1; also elsewhere on the board
/Cell Measurement/C10: R40.1; also elsewhere on the board
/Cell Measurement/CENTER_CHG_DSG: D5.2 (A), Q2.2 (D), Q3.2 (D), Q4.3 (S), Q5.3 (S)
/Cell Measurement/CFETOFF|CS: U1.29 (CFETOFF/SPI_CS); also elsewhere on the board
/Cell Measurement/CHG: R25.1, U1.45 (CHG)
/Cell Measurement/DCHG: U1.31 (DCHG); also elsewhere on the board
/Cell Measurement/DDSG: U1.32 (DDSG); also elsewhere on the board
/Cell Measurement/DFETOFF: U1.30 (DFETOFF); also elsewhere on the board
/Cell Measurement/DSG: D3.1 (K), R26.1, U1.43 (DSG)
/Cell Measurement/LD: R23.2, U1.41 (LD)
/Cell Measurement/MISO: U1.27 (SDA/SPI_MISO); also elsewhere on the board
/Cell Measurement/MOSI: U1.28 (HDQ/SPI_MOSI); also elsewhere on the board
/Cell Measurement/PACK: R22.2, U1.42 (PACK)
/Cell Measurement/PCHG: R31.1, U1.40 (PCHG)
/Cell Measurement/PDSG: R33.1, U1.39 (PDSG)
/Cell Measurement/REG18: C35.1, U1.24 (REG18)
/Cell Measurement/SCLK: U1.26 (SCL/SPI_SCLK); also elsewhere on the board
/Cell Measurement/SRN: C1.1, C2.1, R3.1, U1.20 (SRN)
/Cell Measurement/SRP: C1.2, C2.2, R1.2, U1.18 (SRP)
/Cell Measurement/TS1: U1.21 (TS1); also elsewhere on the board
/Cell Measurement/TS3: U1.23 (TS3); also elsewhere on the board
/RST_SHUT: C16.2, D8.2 (A2), R19.1, SW3.2, U1.33 (RST_SHUT); also elsewhere on the board
/WAKE: C17.1, D8.1 (A1), SW2.2, U1.22 (TS2/WAKE); also elsewhere on the board
BATT+_CONST: C32.2, D1.2 (A), D2.2 (A), Q2.3 (S), R24.2, R29.1; also elsewhere on the board
GND: C10.2, C11.2, C12.2, C14.2, C17.2, C28.2, C29.2, C35.2, D8.3 (common), R1.1, R2.2, R19.2, R32.2, SW2.1, U1.17 (VSS); also elsewhere on the board
unnamed: C3.1, C9.2, R4.2, U1.10 (VC5)
unnamed: C3.2, C4.1, R5.2, U1.12 (VC4)
unnamed: C4.2, C6.1, R7.2, U1.13 (VC3)
unnamed: C5.2, C7.1, JP7.2, R8.2, U1.6 (VC7)
unnamed: C6.2, C8.1, R9.2, U1.14 (VC2)
unnamed: C7.2, C9.1, R10.2, U1.8 (VC6)
unnamed: C8.2, C10.1, R11.2, U1.15 (VC1)
unnamed: C11.1, C12.1, C13.2, R36.1, U1.47 (BAT)
unnamed: C13.1, U1.46 (CP1)
unnamed: C14.1, R12.2, U1.16 (VC0)
unnamed: C24.1, R40.2, U1.48 (VC10)
unnamed: C24.2, C25.1, JP9.2, R41.2, U1.2 (VC9)
unnamed: C5.1, C25.2, JP7.1, JP9.1, R6.2, U1.4 (VC8)
unnamed: C26.1, Q1.3 (E), U1.36 (REGIN)
unnamed: C29.1, Q1.2 (C), R21.1
unnamed: C32.1, C33.2
unnamed: D1.1 (K), R36.2
unnamed: D2.1 (K), Q2.1 (G), R24.1, R25.2
unnamed: D3.2 (A), R28.1
unnamed: D4.1 (K), Q3.1 (G), R26.2, R27.1, R28.2
unnamed: D5.1 (K), R20.2
unnamed: Q1.1 (B), R32.1, U1.37 (BREG)
unnamed: Q4.1 (D), R29.2, R30.2
unnamed: Q4.2 (G), R30.1, R31.2
unnamed: Q5.1 (D), R34.2, R35.1
unnamed: Q5.2 (G), R33.2, R34.1
unnamed: R20.1, R21.2

Notes on the sheet:
REG1 Bypass

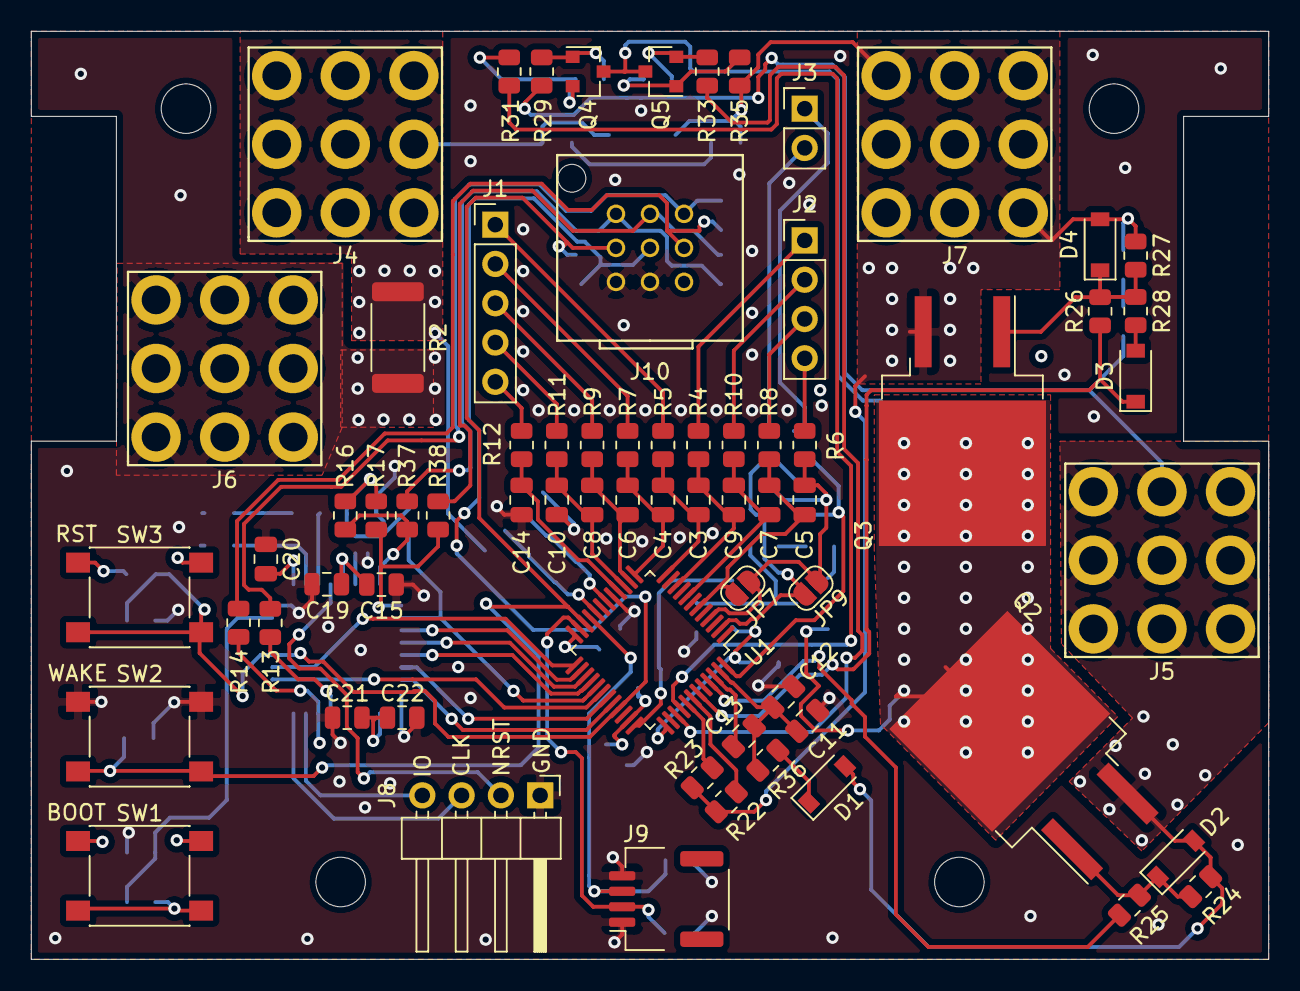
[picture p7: board bms.kicad_pcb from above]

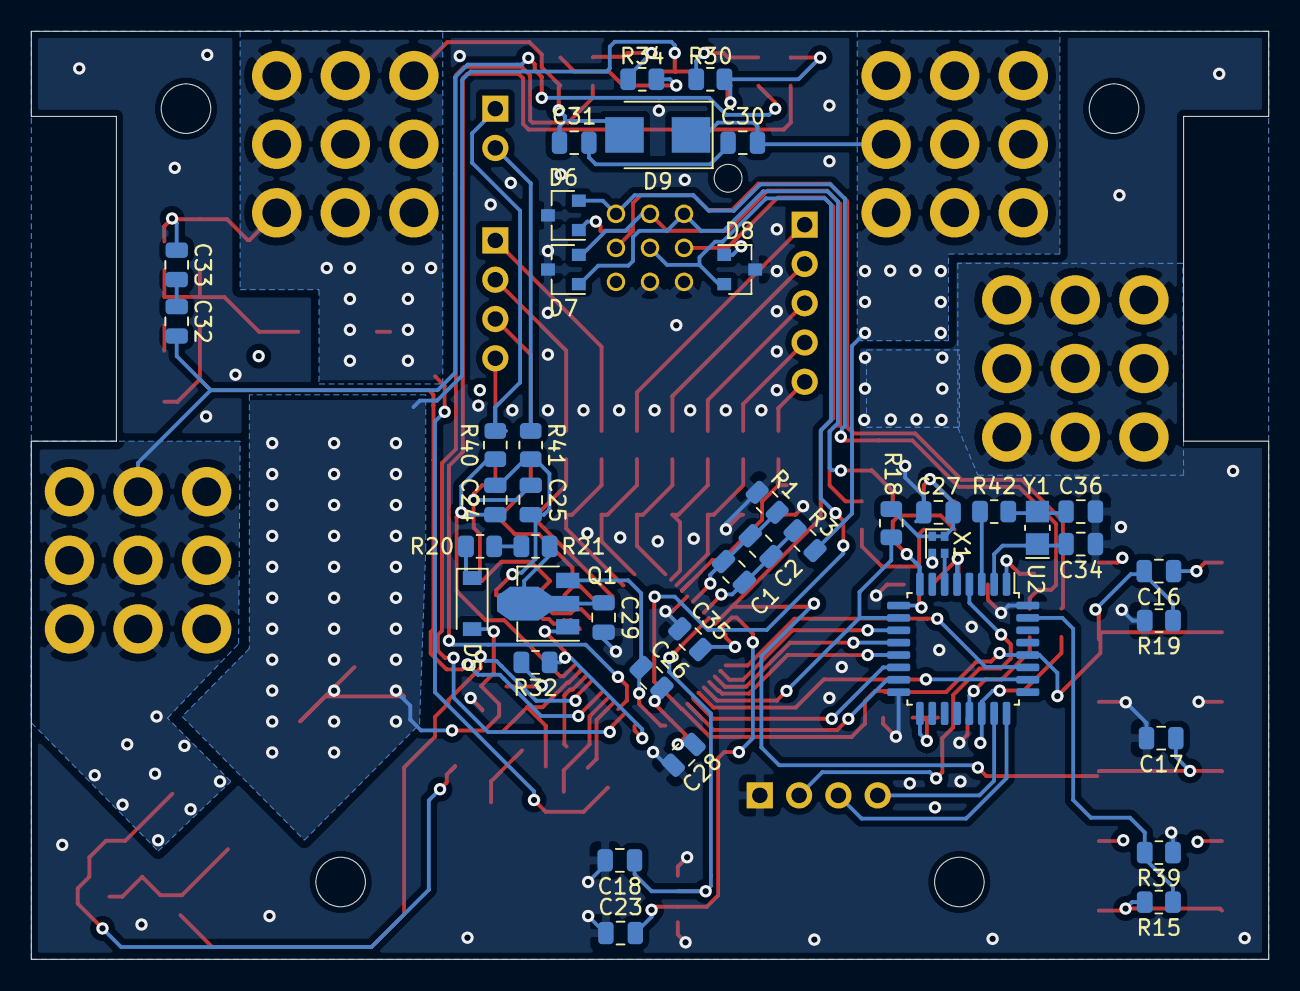
[picture p8: board bms.kicad_pcb from below]

Board: 4 copper layers, 80.0 x 60.0 mm, 115 parts (42 on the bottom side), 83 nets.
