mabecabu/farasis_p10a_pack/(commit log)

2021-02-10 add datasheets, start schematic capture
    [bms.kicad_pcb, bms.sch, cell_measurement.sch, microcontroller.sch]
2021-04-21 finished cell tab board
    [bms.kicad_pcb, bms.sch, cell_interconnect.sch, cell_measurement.sch, microcontroller.sch]
2021-04-24 AFE mostly complete
    [bms.kicad_pcb, bms.sch, cell_interconnect.sch, cell_measurement.sch, microcontroller.sch]
2021-05-02 connectors, microcontroller
    [bms.sch, microcontroller.sch]
2021-05-07 microcontroller added
    [bms.kicad_pcb, bms.sch, cell_measurement.sch, microcontroller.sch]
2021-05-07 split boards to two separate projects
    [8S_interconnect.sch, bms.kicad_pcb, bms.sch, cell_interconnect.kicad_pcb, cell_interconnect.sch, cell_measurement.sch, microcontroller.sch]
2021-05-12 pretty much ready to go
    [bms.kicad_pcb, bms.sch, cell_measurement.sch, microcontroller.sch]
2021-05-13 rev1 as manufactured
    [8S_interconnect.sch, bms.kicad_pcb, bms.sch, bms.xlsx, cell_interconnect.kicad_pcb, cell_measurement.sch, microcontroller.sch]
